bigjosh/scan-mosfet/arduino-scanner/arduino-scanner-spec.md

We want to create a MOSFET scanner based on an arduino uno. 

Specs:

Should be able to drive source, drain, and gate at 0-15V in any combination and should be able to measure Ids from 0-1000uA and Igs from 0uA-100uA. All voltages and currents driven/measured with better than 5% accuracy.
