bigjosh/scan-mosfet/docs/batches/2026-10-30-new-tubes/scan-mosfet-a-20261030_003115.jpg

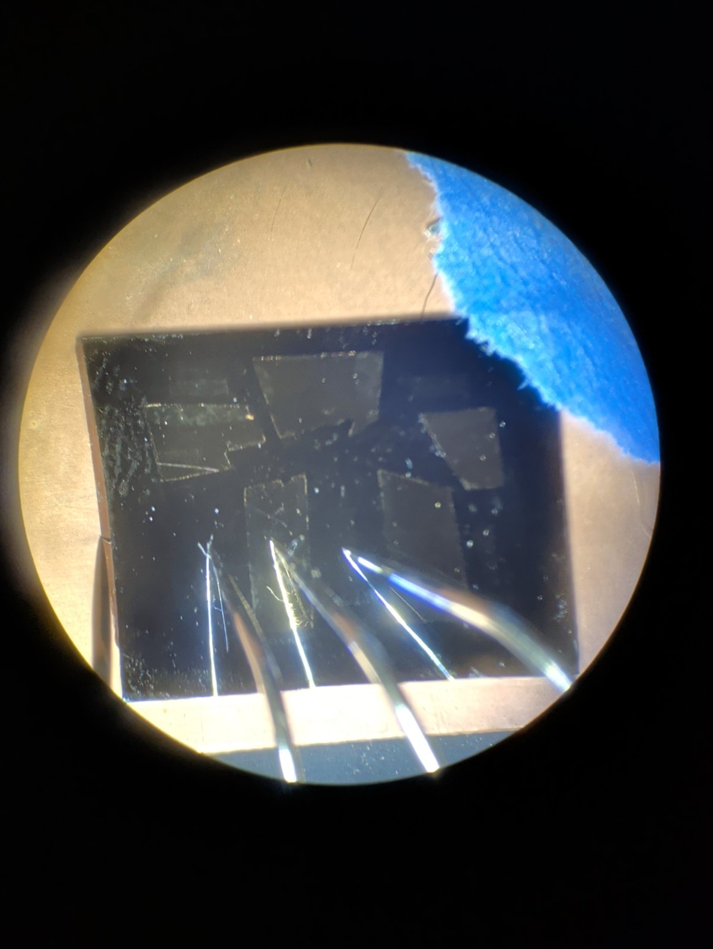
docs/batches/2026-10-30-new-tubes/scan-mosfet-a-20261030_003115.jpg
