bigjosh/scan-mosfet/(commit log)

2025-11-03 Initial commit. Working.
    [scan-mosfet-20251103_114648.csv, scan-mosfet-20251103_115109.csv]
2026-06-10 Bench tooling: Vgs-outer sweep in scan_mosfet, inverter + analysis scripts
    Tracks the previously-untracked heatmap.py, inverter_regime_search.py,
    plot_vds8_fit.py, scan_inverter.py and visualize_scan.py, plus the
    Vgs-outer-loop rework of scan_mosfet.py.
    [heatmap.py, inverter_regime_search.py, plot_vds8_fit.py, scan_inverter.py, scan_mosfet.py, visualize_scan.py]
2026-06-10 Add Arduino-based MOSFET scanner v1 (arduino-scanner/)
    Uno R3 + 2x MCP4725 rig (0-5 V): bit-banged open-drain I2C with shared
    SDA and one SCL per DAC (identical modules, no address straps), dual
    ADC-reference MEAS with bandgap VDD self-measurement, 3-phase device
    cycle (gate leakage, +/-Vgs Ids maps) writing legacy-compatible
    per-phase CSVs and charts, guided bring-up wizard (PINTEST harness
    diagnostics, no-DUT selftest, jumper-wire Ohm's-law functional tests,
    DMM calibration), and a wiring schematic generator.
    Bring-up fully green and bandgap-calibrated 2026-06-10; first device
    scanned the same day. .gitignore added so measurement outputs stay
    untracked.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
    [bring-up.py, mosfet_scanner.ino, scan_arduino.py, wiring_diagram.py]
2026-06-11 Add browser UI for the Arduino scanner (/docs, GitHub Pages)
    Chrome-Android-first web app replicating scan_arduino.py + bring-up.py:
    - WebUSB transport speaking CDC-ACM in JS (Android has no Web Serial);
    Web Serial transport on desktop Chrome; auto-picked. Same firmware
    protocol, same measurement math (dual-ref pick, VDD-compensated codes),
    same CSV columns and filenames.
    - Vanilla ES modules, no build step. Hand-rolled canvas charts with live
    per-point updates (viridis Vgs families, log leak bars). Scan history
    in IndexedDB with on-demand CSV downloads. Full 8-step bring-up wizard
    including jumper tests and DMM calibration. PWA with offline cache and
    wake lock. ?demo runs a si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
2026-06-11 Web UI: combined mirror chart for the two gate polarities
    Replaces the separate phase-2/3 tabs with one Curves view: the +Vgs
    family above and the -Vgs family below a shared x-axis seam at gate = 0.
    Both halves plot positive magnitudes (x = |V(High-Low)| measured with the
    same range/steps, y = |Ids|), each half autoscaled, one viridis colorbar
    spanning the full commanded-Vgs range. History view uses the same chart.
2026-06-11 Web UI: split the gate polarities into two stacked charts
    The mirror view implied one shared axis, but phase 3 physically swaps
    the source/drain roles, so each regime now gets its own chart and
    reference: top is Vgs>0 with x = V_high - V_low (Vlow ~ 0), below it
    Vgs<0 with x = V_low - V_high (Vlow ~ 5 V), current positive in the
    Low->High direction. Each chart autoscales (the reversed axis now zooms
    to the diode-clamped range) and carries its own Vgs colorbar. History
    view matches. Removes the now-unused MirrorChart.
2026-06-11 Web UI: USB troubleshooting mode + broader CDC device filter
    Phone WebUSB chooser reports no-compatible-devices despite a working
    board (3rd-party terminal app talks to it fine). Add a USB? diagnostics
    button that dumps userAgent, previously-granted devices, an UNFILTERED
    device picker, and per-interface class/endpoint/claim results - this
    distinguishes filter misses from devices Chrome cannot see at all
    (held by another app, or hidden by class). Also add a classCode=2
    OR-filter so any CDC device matches, not just Arduino VIDs.
2026-06-11 Web UI: retry USB interface claims after a device reset
    Claim failures on Android usually mean another app (serial terminal set
    as default handler) holds the interfaces. On failure: reset the device
    to clear foreign claims, reconfigure, retry once, and if it still fails
    explain the likely cause and remedy instead of a bare claim error.
2026-06-11 Add Android shell app: WebView + native USB serial bridge (/android)
    Chrome on Android blocks wired CDC serial both ways (WebUSB refuses to
    claim the CDC-data interface; wired Web Serial sits behind a
    non-functional flag), so phones get a 2 MB shell: a fullscreen WebView
    loading the GitHub Pages app plus window.AndroidSerial, a native bridge
    built on usb-serial-for-android (CDC + CH340 + FTDI + CP210x). The web
    transport layer auto-prefers the bridge; CSV downloads route through
    MediaStore into system Downloads; USB-attach intent grants permission
    on plug-in; keep-screen-on while open. App features still ship via git
    push - the APK only changes when the bridge does.
    Built with JDK 17 + cmdl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
2026-10-30 Add Arduino-sense scanner, batches, photo drop and batch reports
    - scan_mosfet_a.py: Ids from an Uno reading a sense resistor in the source leg,
    gate current from the Joulescope in the CH2 line; --vgs-offset for an inline
    gate battery, --ch2-max to protect the Joulescope, --batch, serial open retry
    - scan_mosfet.py: --vgs-offset, --batch, CH2 range check, photo hint with QR
    - plot_mosfet_a.py: live two-panel view (Ids per Vgs, gate current per Vds)
    with a photo/note panel; visualize_iv.py: live 2D Ids vs Vds per Vgs
    - photo_drop.py: LAN upload page + QR code to attach phone photos and notes
    - report_batch.py: HTML report per batch plus a self-contained copy,
    --publish into docs/batch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
2026-10-30 Publish batch report 2026-10-30-new-tubes (6 scans)
    Claude-Session: https://claude.ai/code/session_01TcopcKGFWcvrJmPQ7p4deG
2026-10-30 Republish batch report 2026-10-30-new-tubes (scans complete)
    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
2026-10-30 Republish batch report 2026-10-30-new-tubes
    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
